muraguchi/gameboy_uart_dumper/kicad/gameboy_uart_dumper.pdf

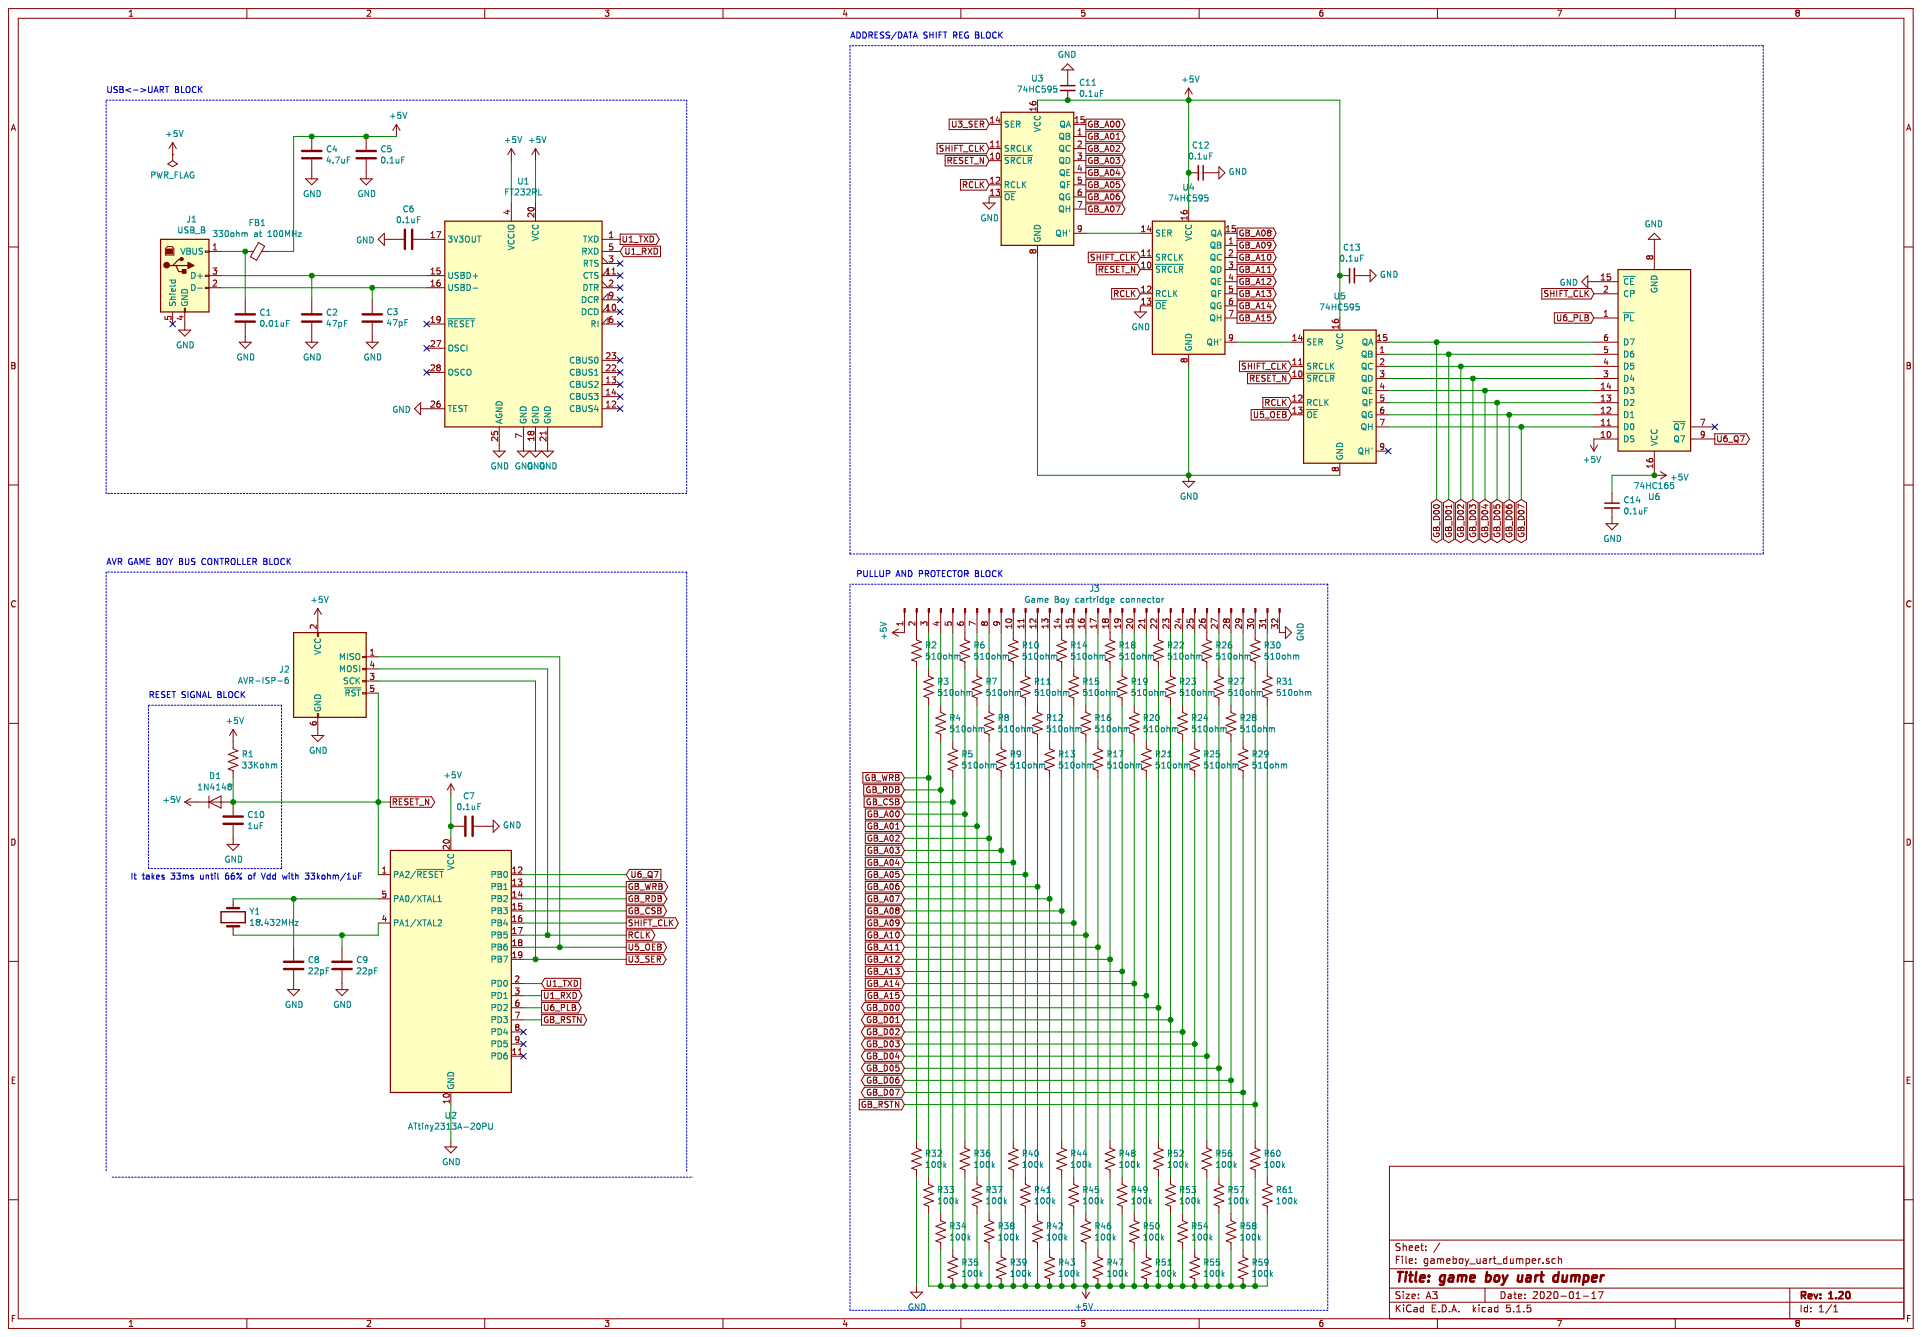
[picture p1: page 1]
