muraguchi/gameboy_uart_dumper/(commit log)

2020-01-01 Added kicad files
    [gameboy_uart_dumper.kicad_pcb, gameboy_uart_dumper.sch]
2020-01-05 Update circuit (divide GB_RDB into GB_RDB and U6_PLB and changed crystal from 10MHz to 18.432MHz) and update firmware and software (transferrate 19.2kbps->430.8kbps. support TAMA5 dumping. fixed glob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
    [read_header.py]
2020-01-18 Added GB reset signal and header/global checksum functionality
    [config.py, main.c, read_header.py, read_rom.py, verify_sum.py]
2020-06-14 Fixed ram size address
    [read_header.py, read_rom.py]
